pgon/ps_transmitter/doc/prototipo V0.1/alimentación SMI por DO.20211118_151255.jpg

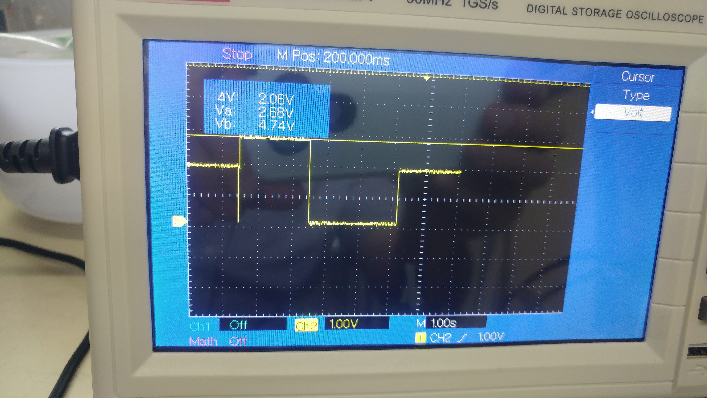
doc/prototipo V0.1/alimentación SMI por DO.20211118_151255.jpg
