pgon/ps_transmitter/doc/prototipo V0.1/20211117_111721.jpg

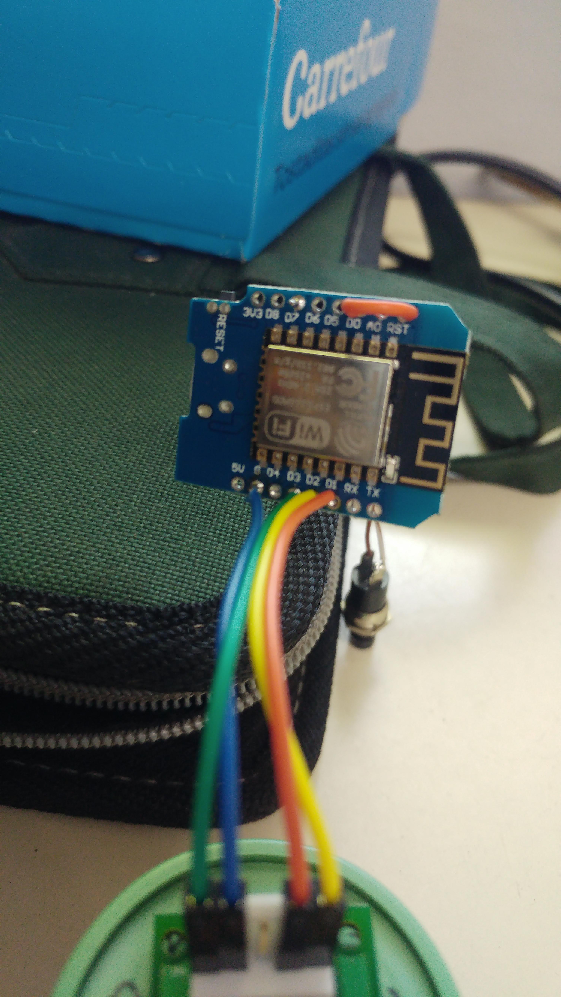
doc/prototipo V0.1/20211117_111721.jpg
