pgon/ps_transmitter/doc/notas desarrollo.pdf

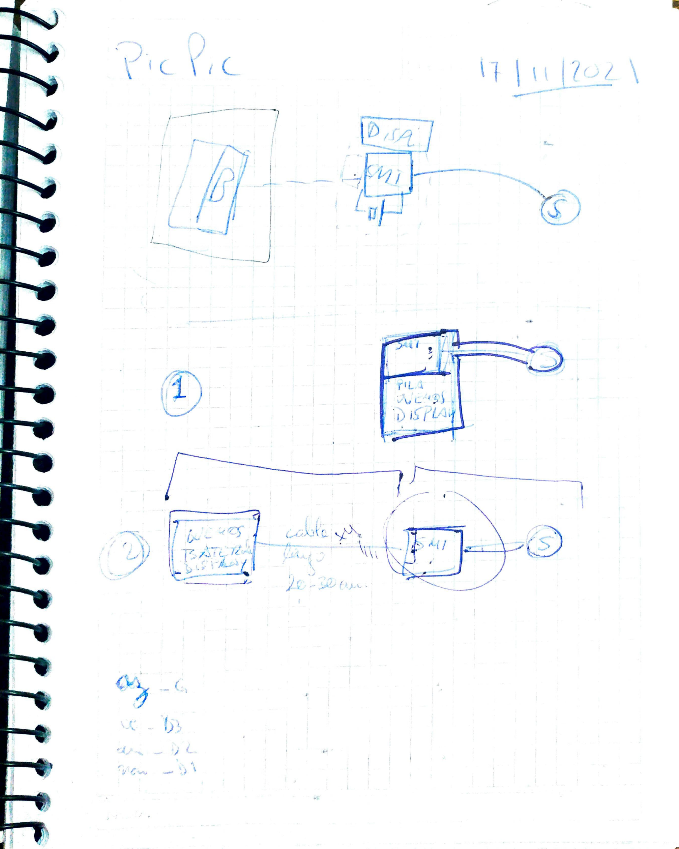
[picture p4: page 1]

1 | TLA DSPLA

7

# e calstes

25 11 207

PR

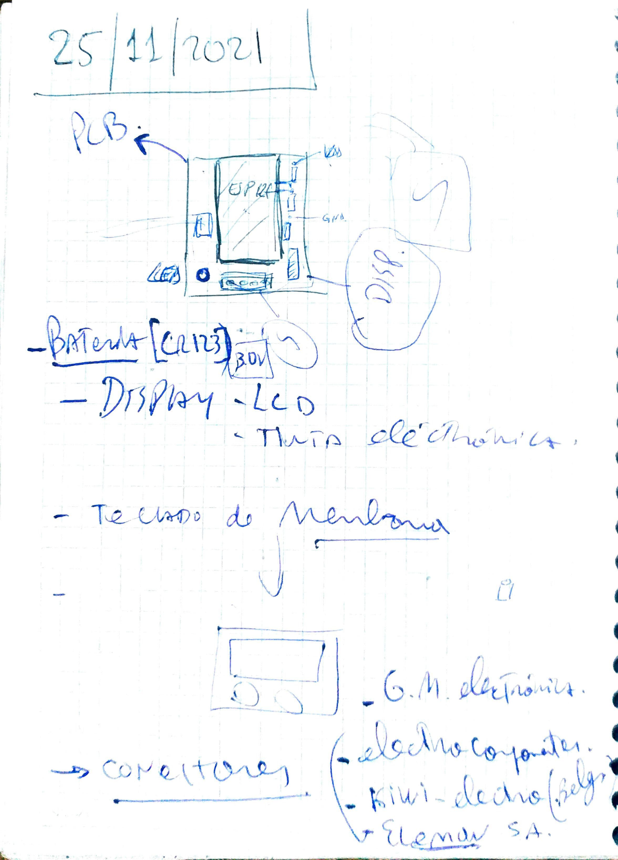
[picture p5: page 2]

# -prTewCans BDV

# - D1sy -leo

# TTA

# Te CD d Menlm

# iui-de Ane

lemd SA.

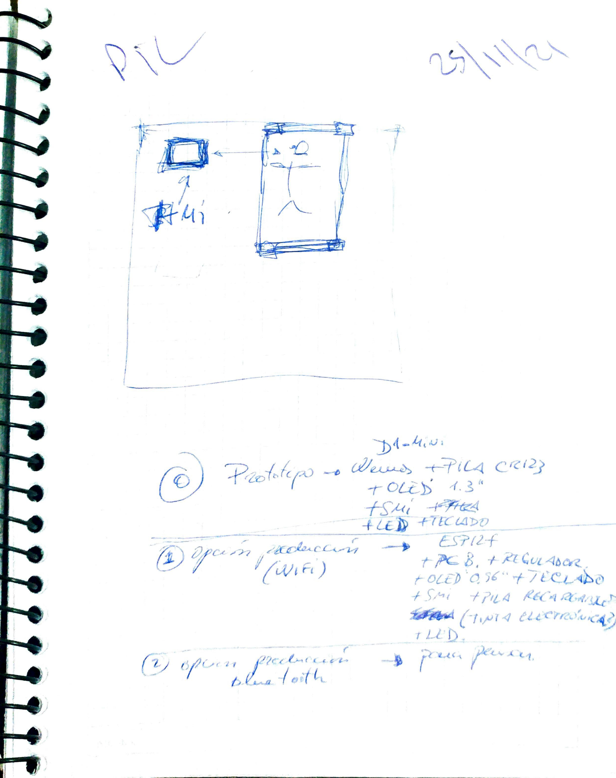
[picture p6: page 3]

D-4,u

## Pahteo - Wed +PilA cei2

TOLÈD 1.3
+S +E+TEC LADO

ESPI2f
e"1wF) | oLED O s6"t /ECLADO
+ S | t ?u 4 KECA AAL

r LUD
