pgon/ps_transmitter/doc/prototipo V0.1/SMI_reparado_20211107_152142.jpg

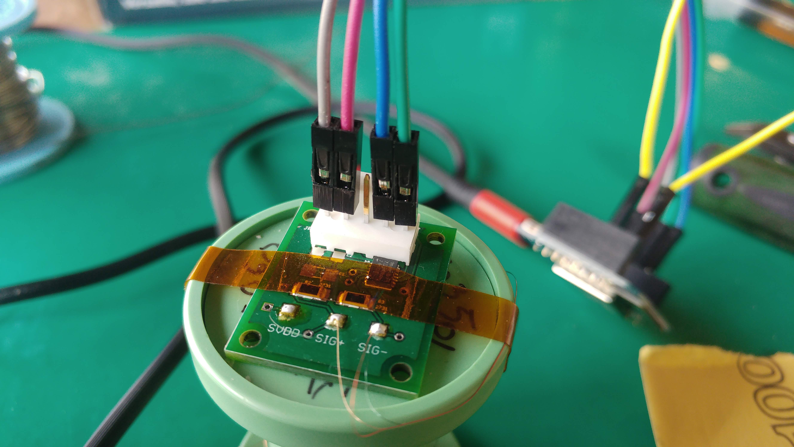
doc/prototipo V0.1/SMI_reparado_20211107_152142.jpg
