pgon/ps_transmitter/doc/alimentacion/Curvas capturadas.pdf

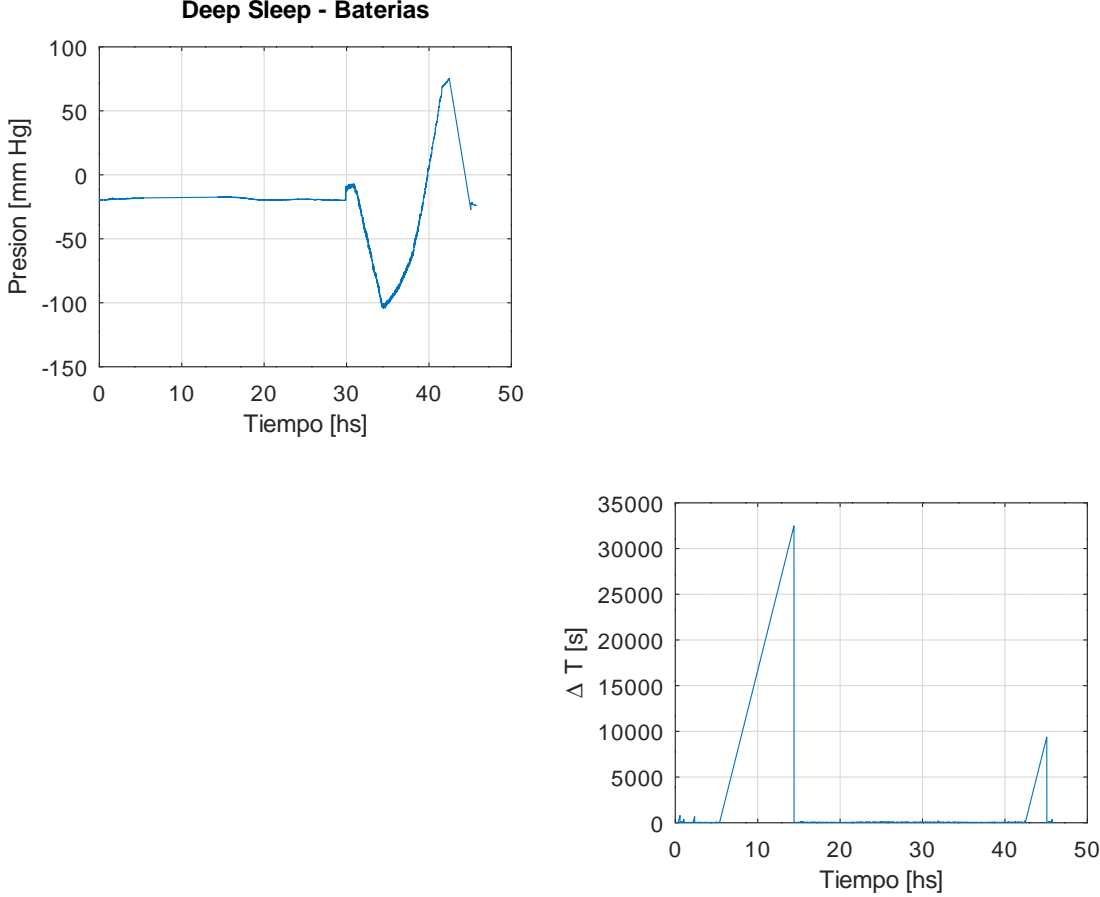
[picture p8: page 1]
Tiempo [hs]

Deep Sleep - Baterias

Presion [mm Hg]

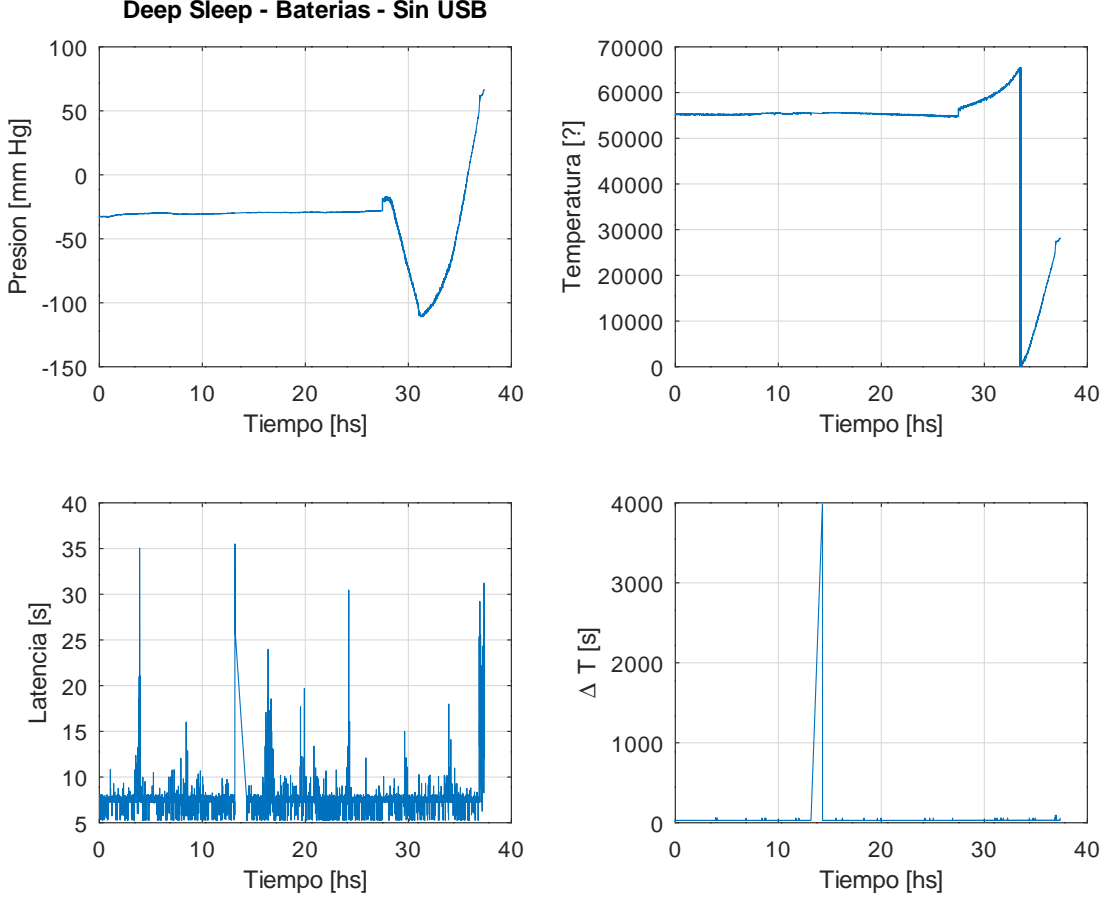
[picture p9: page 2]
Tiempo [hs]; Temperatura [?]; Latencia [s]

Deep Sleep - Baterias - Sin USB

Presion [mm Hg]

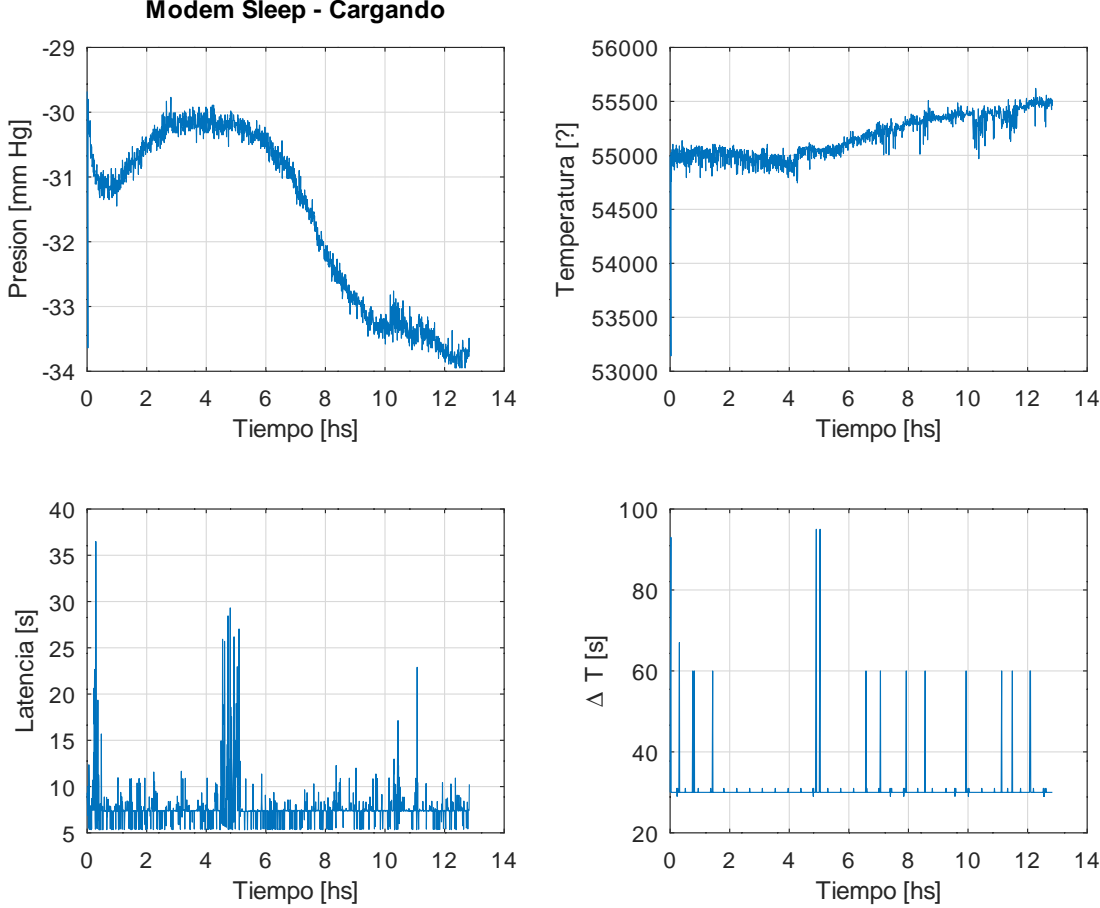
[picture p10: page 3]
Tiempo [hs]; Temperatura [?]; Latencia [s]

Modem Sleep - Cargando

Presion [mm Hg]

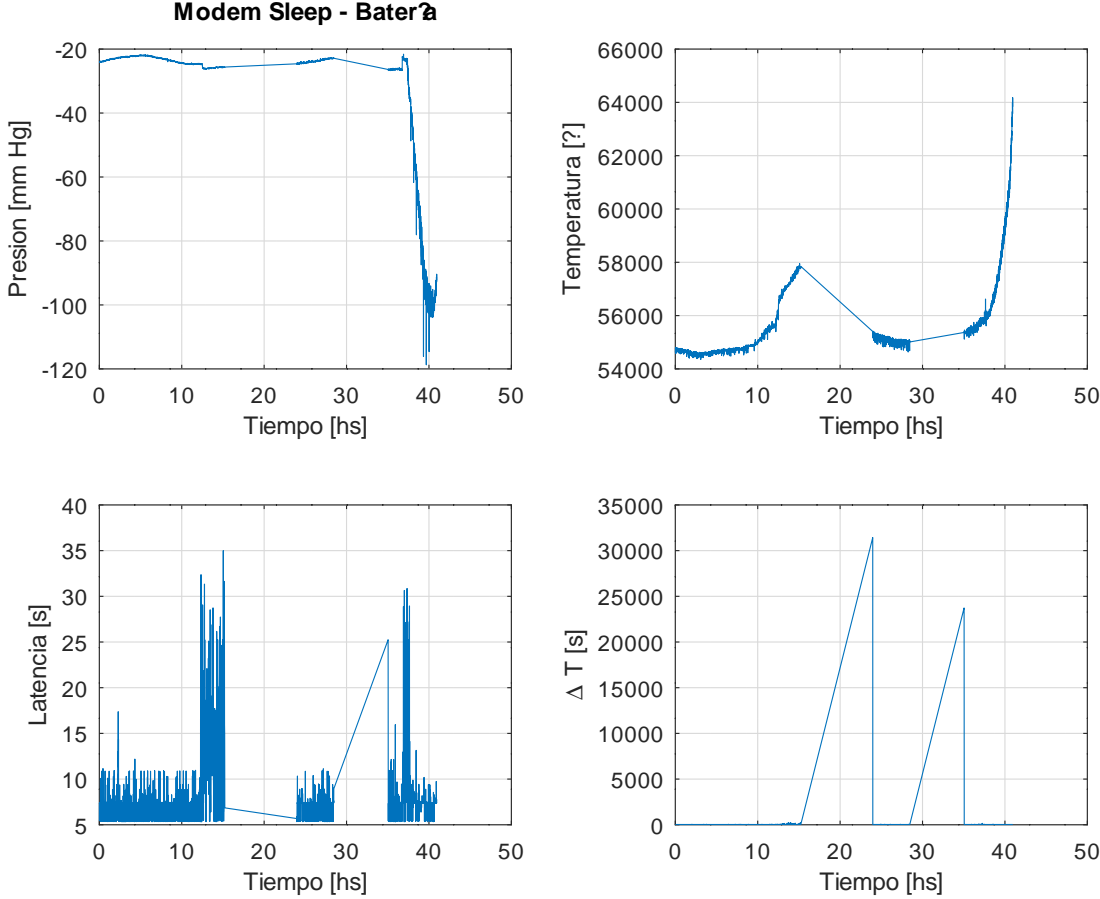
[picture p11: page 4]
Tiempo [hs]; Temperatura [?]; Latencia [s]

Modem Sleep - Bater?a

Presion [mm Hg]

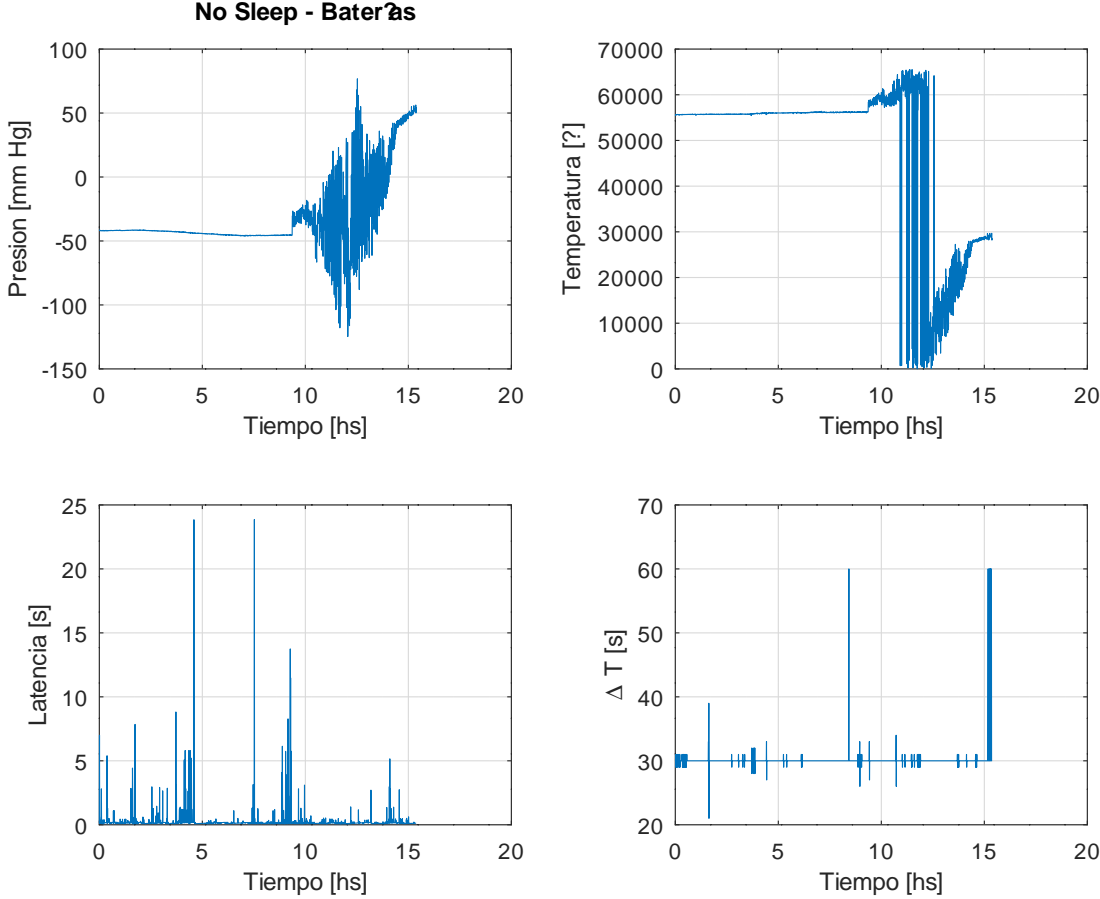
[picture p12: page 5]
Tiempo [hs]; Temperatura [?]; Latencia [s]

No Sleep - Bater?as

Presion [mm Hg]
