pgon/ps_transmitter/hw/ps_transmitter_v0.1/ps_transmitter.pdf

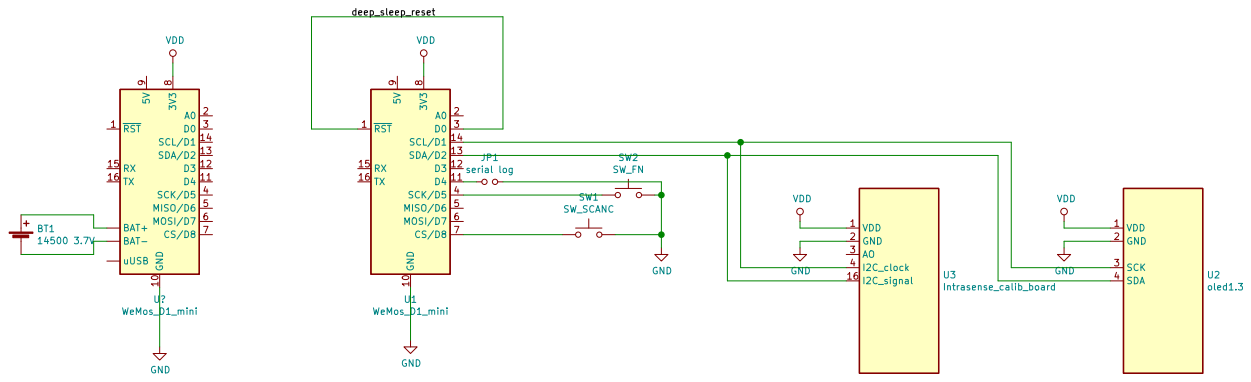
[picture p13: page 1]

IAP
File: ps_transmitter.sch Sheet: /
Id: 1/1 Title: Transmisor de presión WiFi
