pgon/ps_transmitter/doc/alimentacion/datos_vs_bateria.pdf

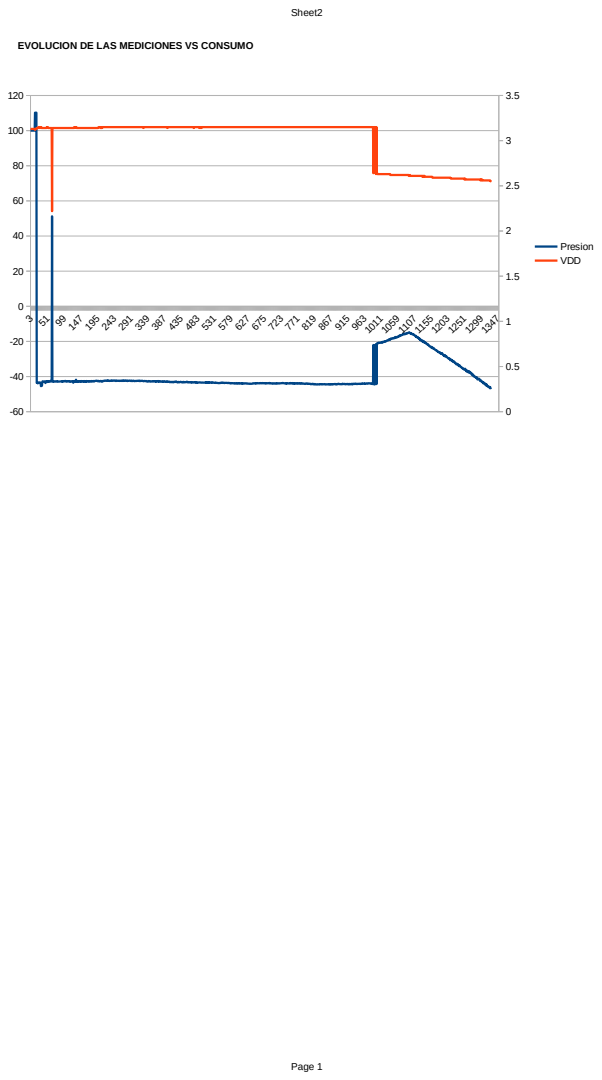
[picture p14: page 1]
Sheet2; Presion VDD

EVOLUCION DE LAS MEDICIONES VS CONSUMO
