pgon/ps_transmitter/hw/ps_transmitter_v0.0/ps_transmitter.pdf

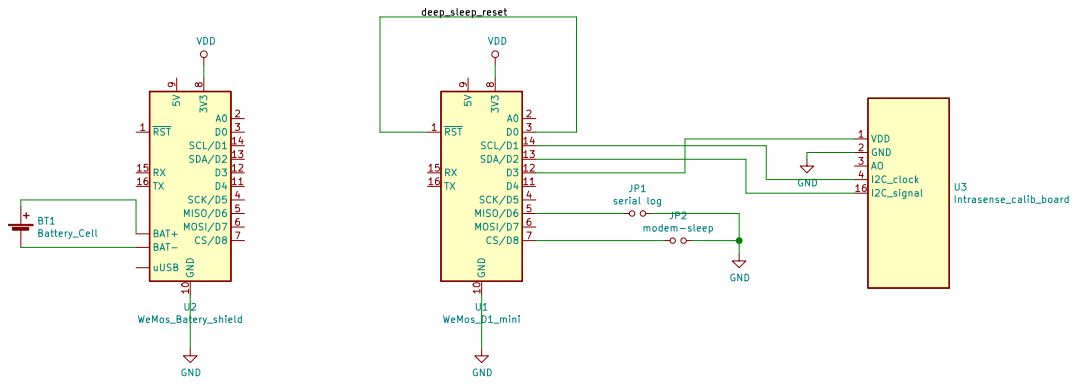
[picture p15: page 1]

9 U1 WeMos_D1_mini BT1 Battery_Cell RST 1 GND 10 D4 11 D3 12 SDA/D2 13 SCL/D1 14 RX 15 TX 16 A0 2 D0 3 SCK/D5 4 MISO/D6 5 MOSI/D7 6 CS/D8 7 3V3

IAP
File: ps_transmitter.sch Sheet: /
Id: 1/1 Title: Transmisor de presión WiFi
