pgon/ps_transmitter/(commit log)

2021-08-07 Commit Inicial
    Se carga los códigos fuente del trasnmisor de presión por WiFi del extremo local y el remoto
2021-08-23 Version prototipo
    Firmware wemos (deep-sleep/modem-sleep, interfase I2C, detección batería)
    Software PC (single thread server, bloqueante, trending, log csv)
    Hardware (esquemático Kicad)
    Doc (resultado de pruebas de autonomía)
    [caracterizacion consumo.ods, datos_capturados.xls, datos_deep_sleep_solo_baterias.csv, datos_deep_sleep_solo_baterias_sin_usb.csv, datos_modem_sleep_bateria.csv, datos_modem_sleep_cargando.csv, datos_modem_sleep_cargando2.csv, datos_sin_descansar_durante_carga.csv]
2021-08-24 Control de estado de batería
    Chequeo de nivel de batería.
    Corrección de la estrategia de encendido/apagado del sensor solo durante deep-sleep, para bajar tiempo de ciclo en modo contínuo
2021-08-25 Actualización metodo de conexión WiFi + manejo de error del sensor
    [common.h, psBlockingTcpServer.cpp, ps_wemos_deep_sleep.ino]
2021-08-25 Ajustes para compilacion en win32 + Deployment
2021-08-26 Agregado de Qt5OpenGL.dll faltante en deploy
2021-11-10 Mejoras de conexion Wemos D1 mini basado en ESP12
2021-11-18 Bias medición tensión. Opción de alimentar SMI desde VDD
2021-11-28 prototipo v0.1 Actualización del código de ESP12f
2021-11-28 doc prototipo V0.1
    [caracterizacion consumo.ods, datos_capturados.xls, datos_deep_sleep_solo_baterias.csv, datos_deep_sleep_solo_baterias_sin_usb.csv, datos_modem_sleep_bateria.csv, datos_modem_sleep_cargando.csv, datos_modem_sleep_cargando2.csv, datos_sin_descansar_durante_carga.csv]
2021-12-04 Inclusion placa fuente en V0.1
    [ps_transmitter.sch]
2021-12-04 Adaptación para ESP32-Wifi
